OriginalOC/Unity64/media/case/case_top.png

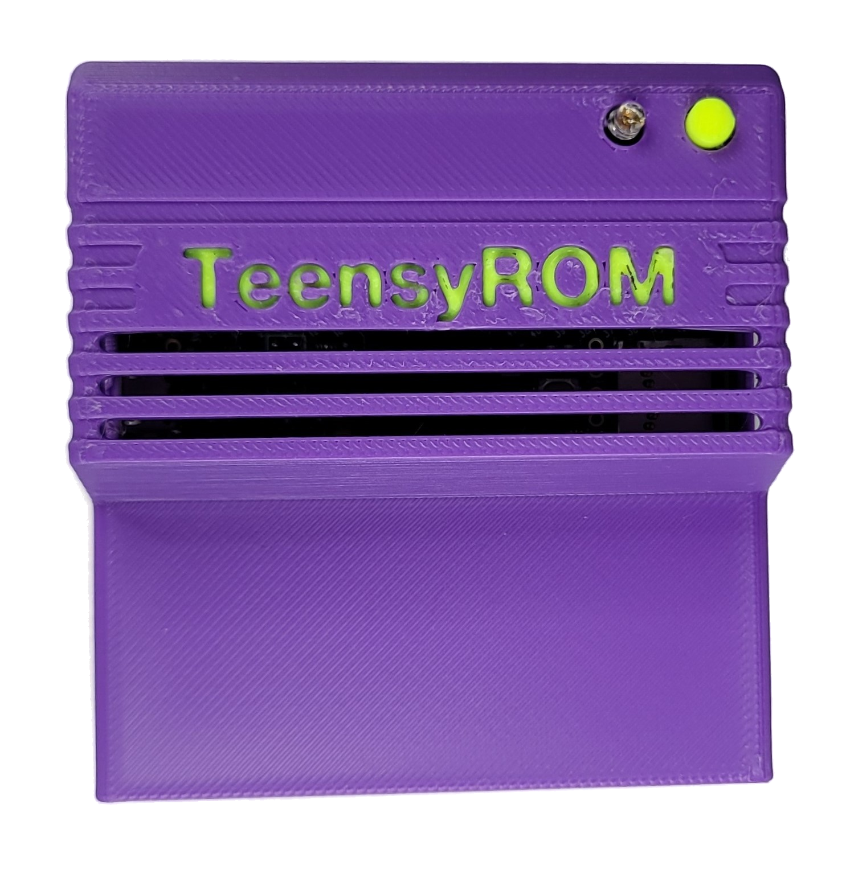
media/case/case_top.png
