OriginalOC/Unity64/media/NFC/Ali_Combo.jpg

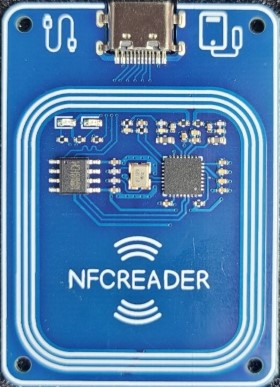
media/NFC/Ali_Combo.jpg
