OriginalOC/Unity64/media/NFC/Discrete_Top_Bot.webp

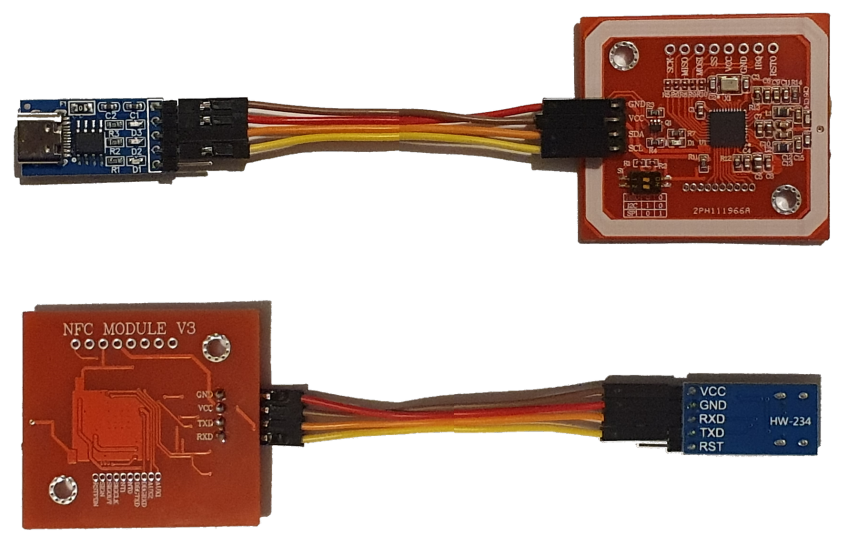
media/NFC/Discrete_Top_Bot.webp
