OriginalOC/Unity64/media/NFC/Elec_Combo.jpg

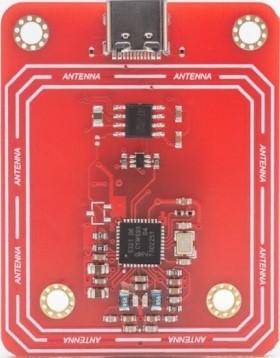
media/NFC/Elec_Combo.jpg
