OriginalOC/Unity64/media/NFC/NFC_1541.jpg

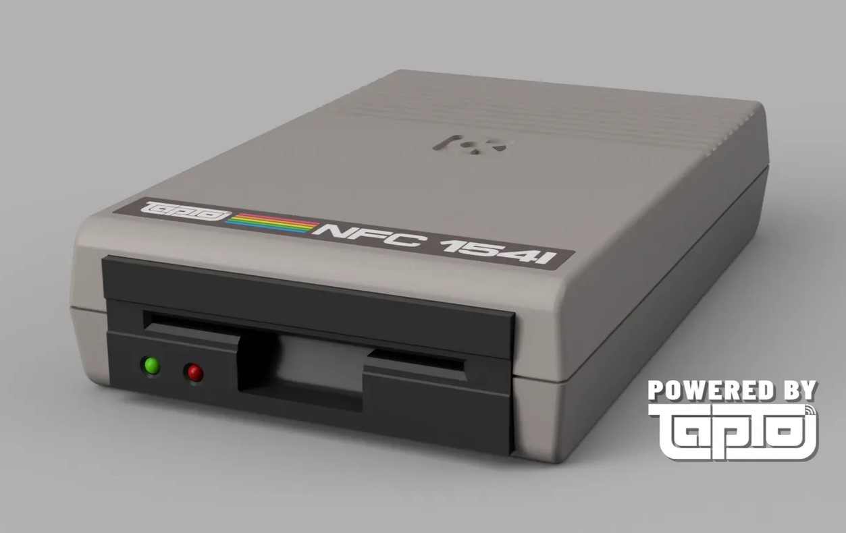
media/NFC/NFC_1541.jpg
