OriginalOC/Unity64/media/NFC/NFC_Engine.jpg

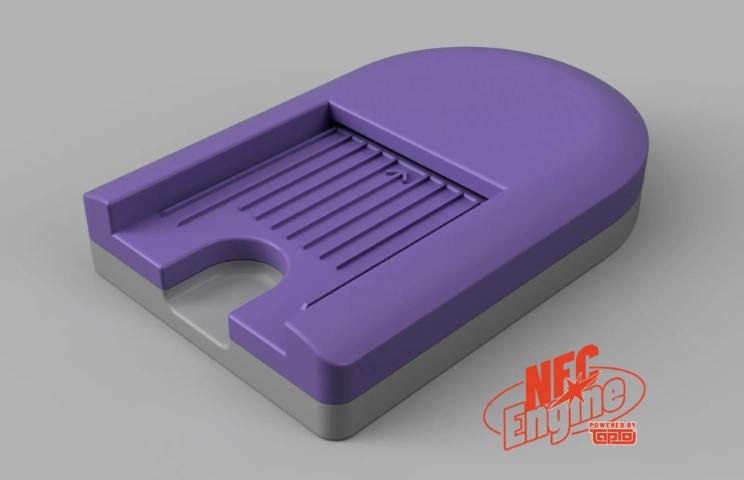
media/NFC/NFC_Engine.jpg
