OriginalOC/Unity64/media/NFC/TapTo_Label_Designer.webp

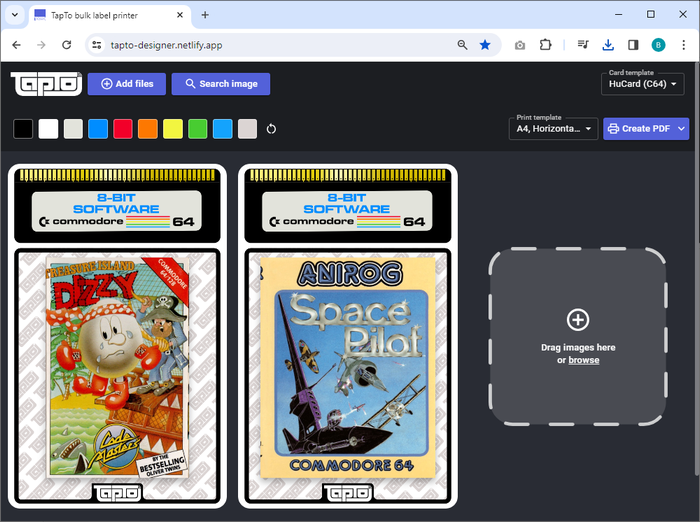
media/NFC/TapTo_Label_Designer.webp
