OriginalOC/Unity64/media/NFC/Write_Tag.jpg

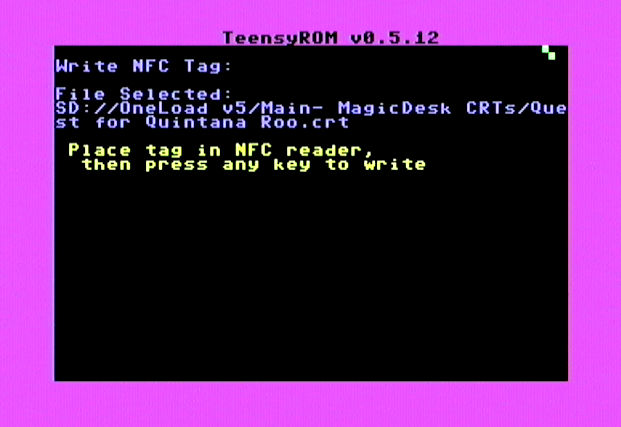
media/NFC/Write_Tag.jpg
