OriginalOC/Unity64/media/Other/tindie-mediums.png

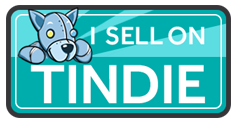
media/Other/tindie-mediums.png
