OriginalOC/Unity64/media/ROMH+VIC timing/TEK0011.JPG

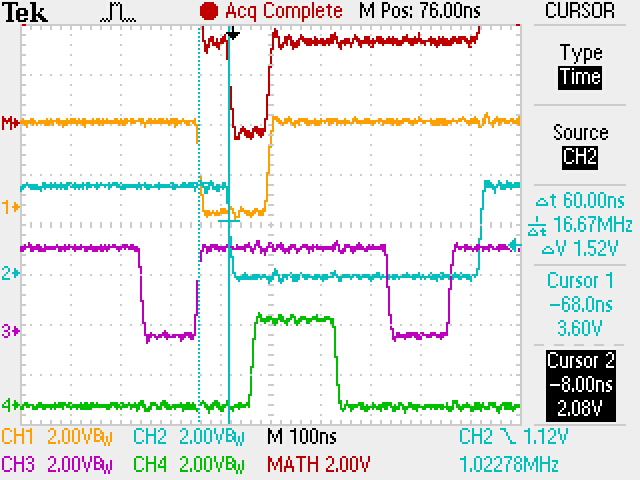
media/ROMH+VIC timing/TEK0011.JPG
