OriginalOC/Unity64/media/ROMH+VIC timing/TEK0014.JPG

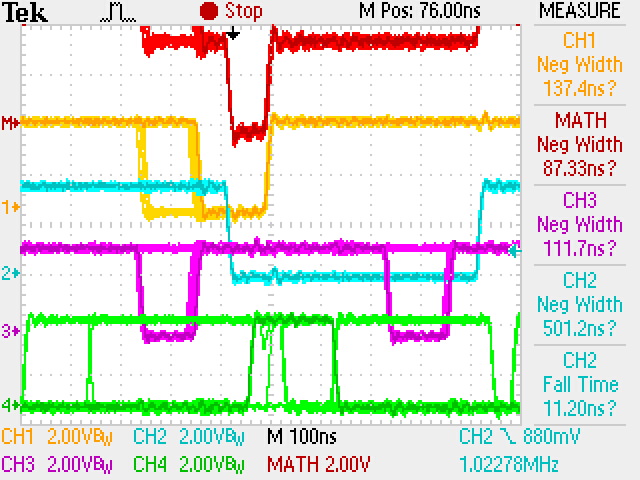
media/ROMH+VIC timing/TEK0014.JPG
