OriginalOC/Unity64/media/Screen captures/ASID Player.png

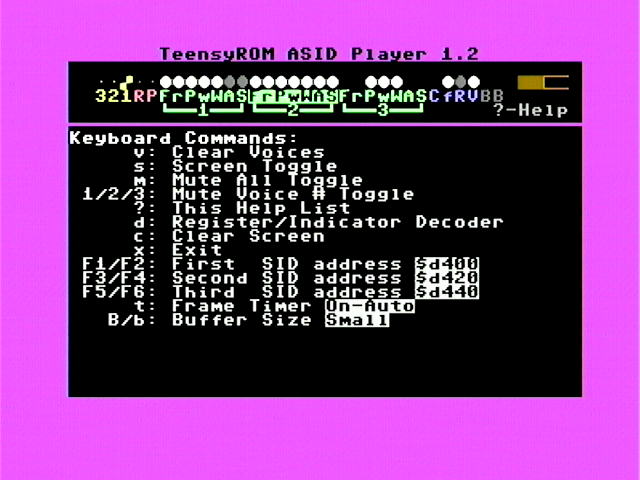
media/Screen captures/ASID Player.png
