OriginalOC/Unity64/media/Screen captures/Color Settings.png

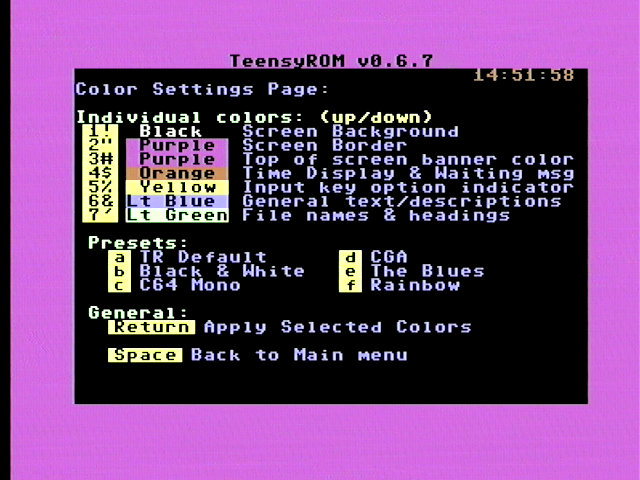
media/Screen captures/Color Settings.png
