OriginalOC/Unity64/media/Screen captures/DMA_Check_Pass.png

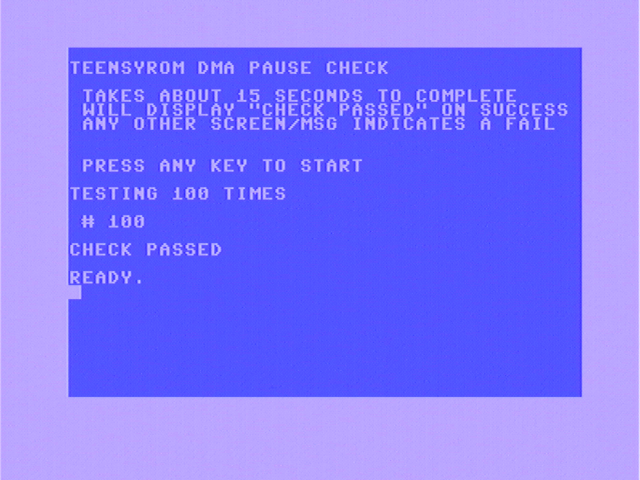
media/Screen captures/DMA_Check_Pass.png
