OriginalOC/Unity64/media/Screen captures/Help Menu.png

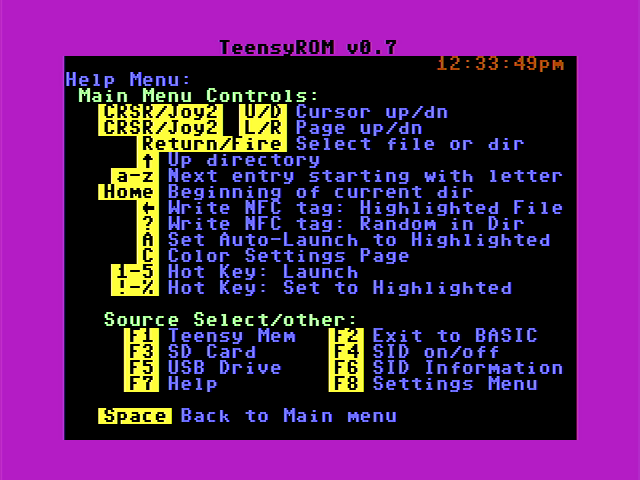
media/Screen captures/Help Menu.png
