OriginalOC/Unity64/media/Screen captures/Main Menu.png

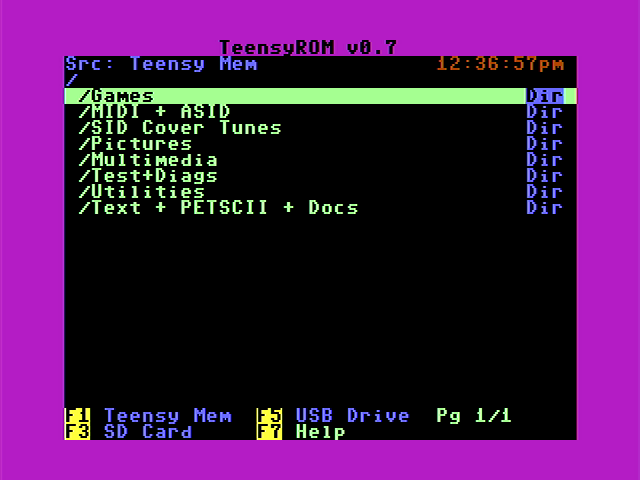
media/Screen captures/Main Menu.png
