OriginalOC/Unity64/media/Screen captures/MIDI to SID.png

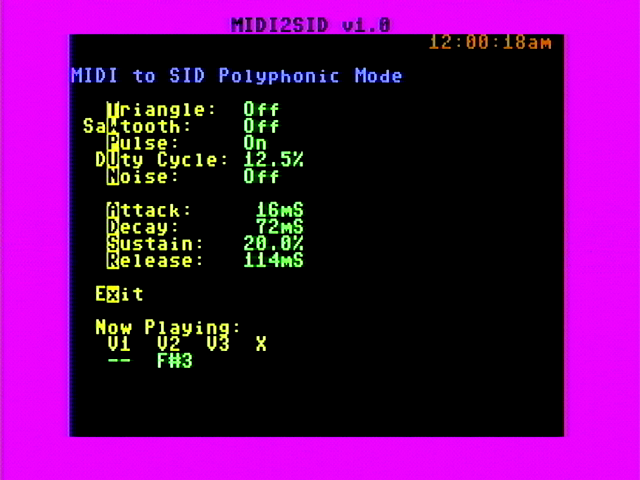
media/Screen captures/MIDI to SID.png
