OriginalOC/Unity64/media/Screen captures/Settings Menu.png

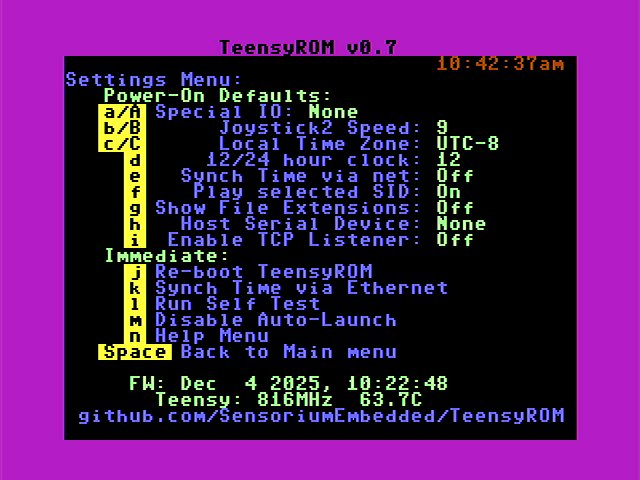
media/Screen captures/Settings Menu.png
