OriginalOC/Unity64/media/Screen captures/SIDInfoPage.png

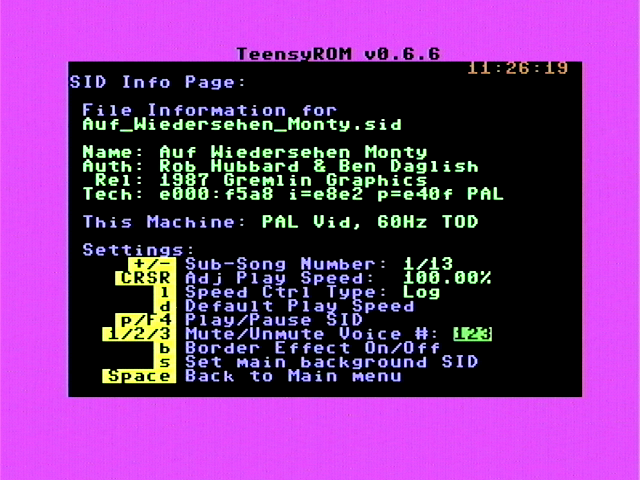
media/Screen captures/SIDInfoPage.png
