OriginalOC/Unity64/media/Screen captures/Text_PETSCII Viewer doc.png

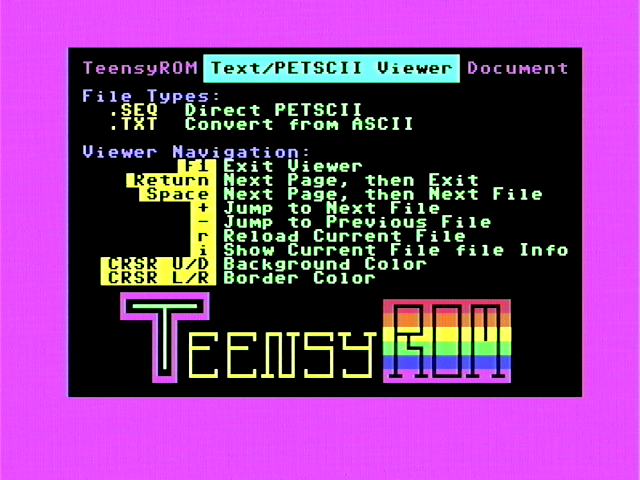
media/Screen captures/Text_PETSCII Viewer doc.png
