OriginalOC/Unity64/media/Screen captures/USB Devices.jpg

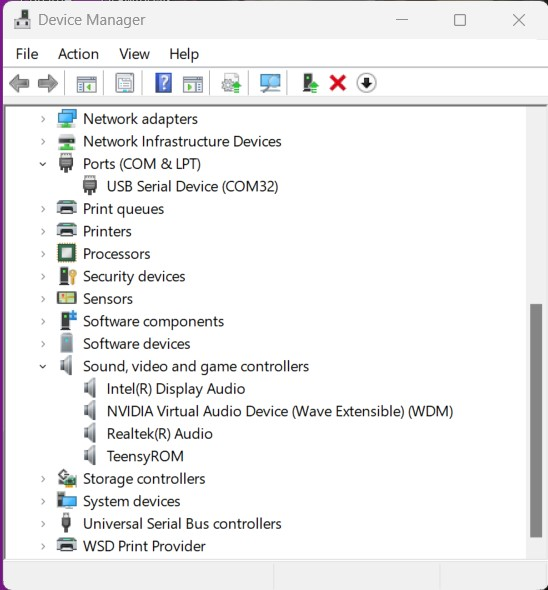
media/Screen captures/USB Devices.jpg
