OriginalOC/Unity64/media/Screen captures/USB Menu.png

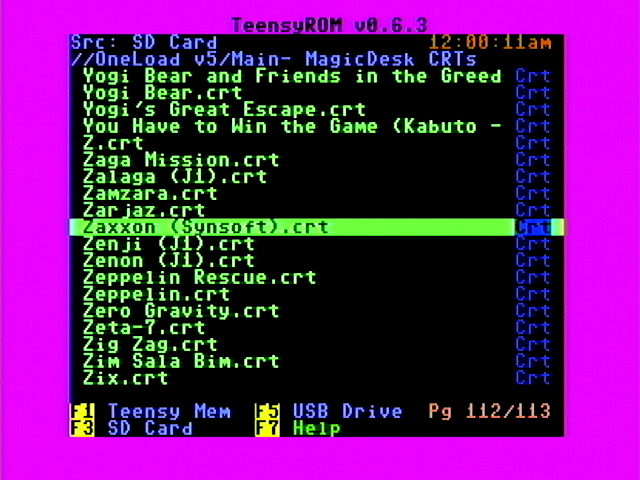
media/Screen captures/USB Menu.png
