OriginalOC/Unity64/media/Screen captures/WinPC x-fer app.png

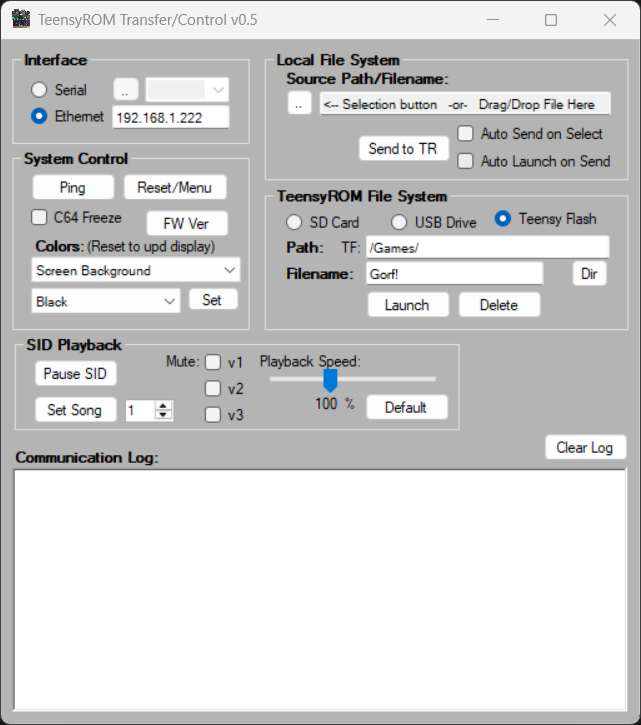
media/Screen captures/WinPC x-fer app.png
