OriginalOC/Unity64/media/Teensy/Teensy Bot Pins.jpg

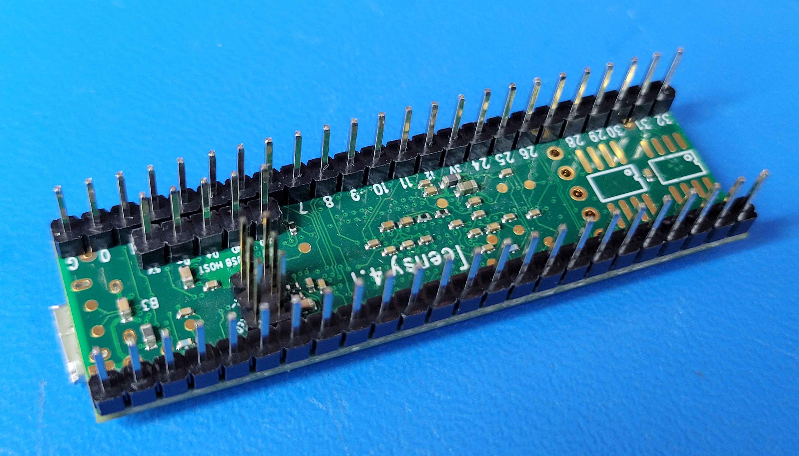
media/Teensy/Teensy Bot Pins.jpg
