OriginalOC/Unity64/media/Teensy/Teensy Power.jpg

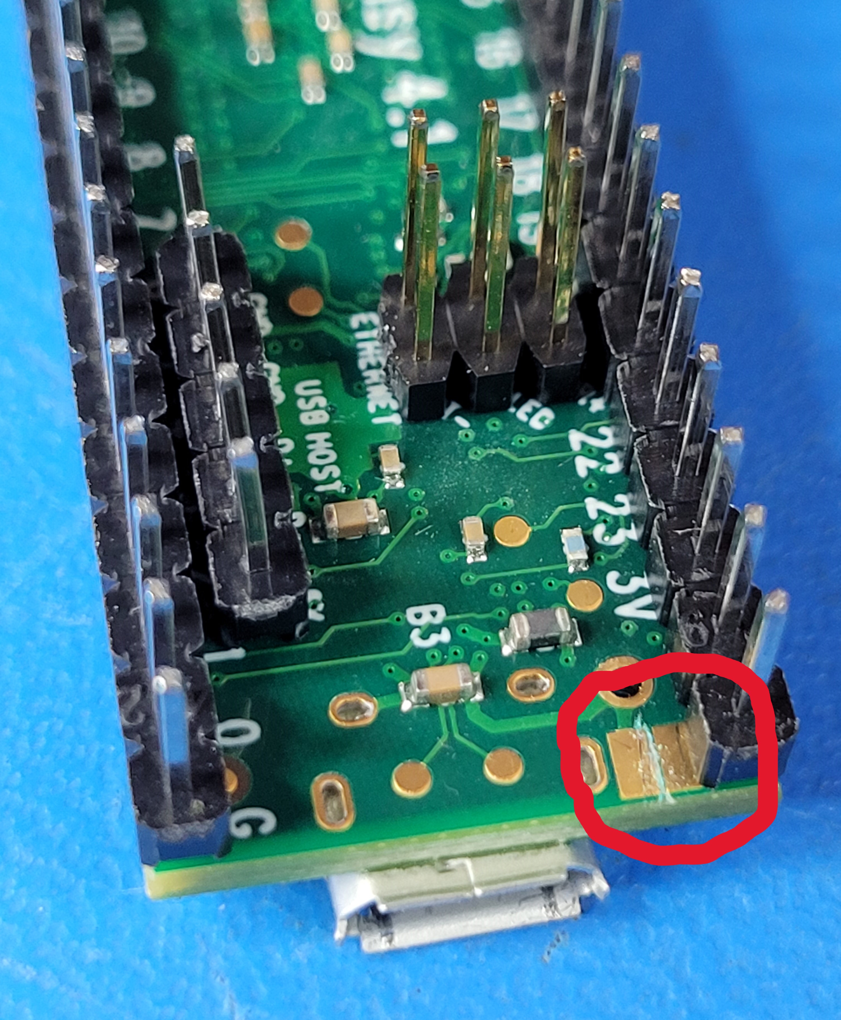
media/Teensy/Teensy Power.jpg
