OriginalOC/Unity64/media/Teensy/Teensy Top Pins.jpg

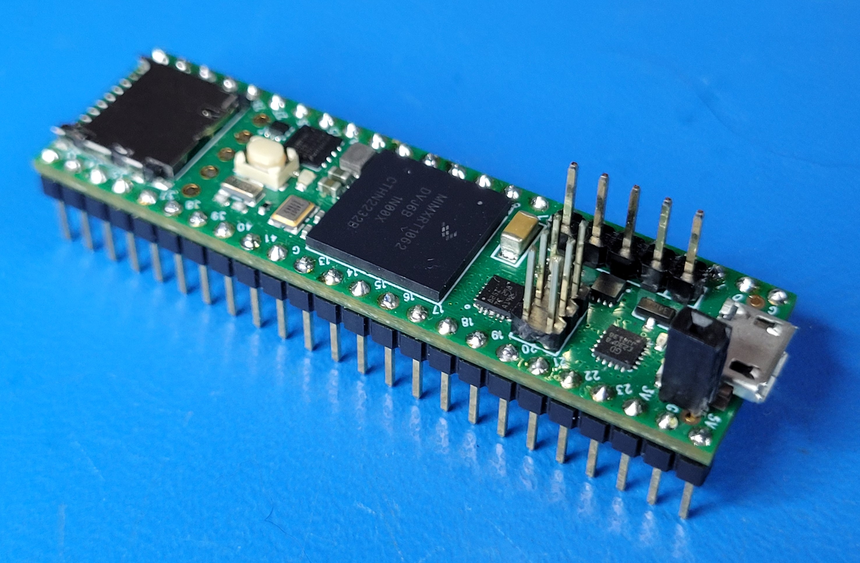
media/Teensy/Teensy Top Pins.jpg
