OriginalOC/Unity64/media/Teensy/USB Power.jpg

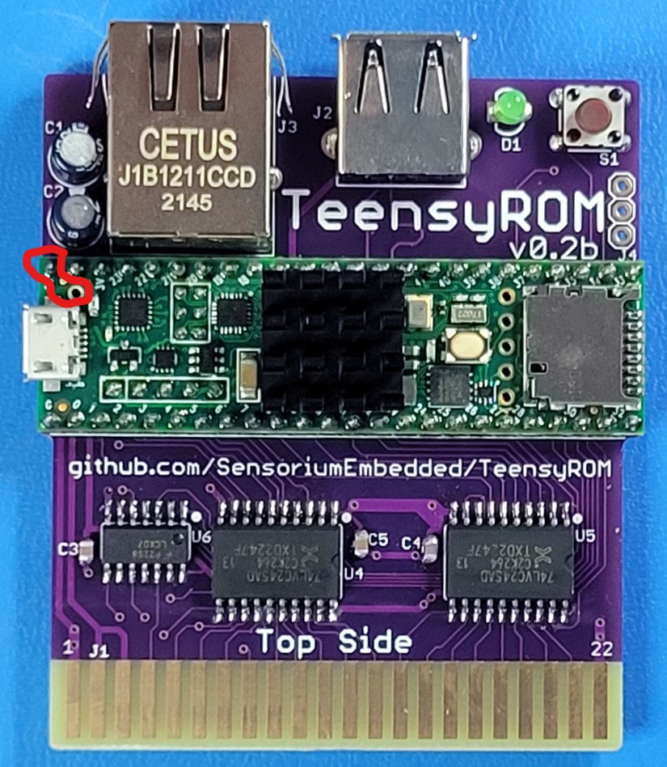
media/Teensy/USB Power.jpg
