OriginalOC/Unity64/media/v0.2b/v0.2b_Bot.jpg

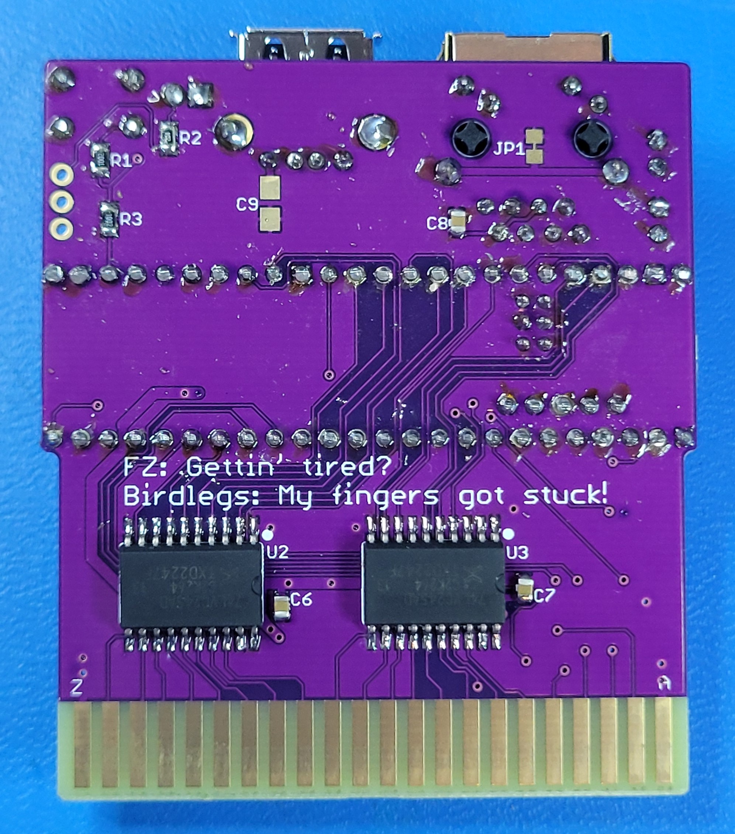
media/v0.2b/v0.2b_Bot.jpg
