OriginalOC/Unity64/media/v0.2b/v0.2b_insitu_USBdrive.jpg

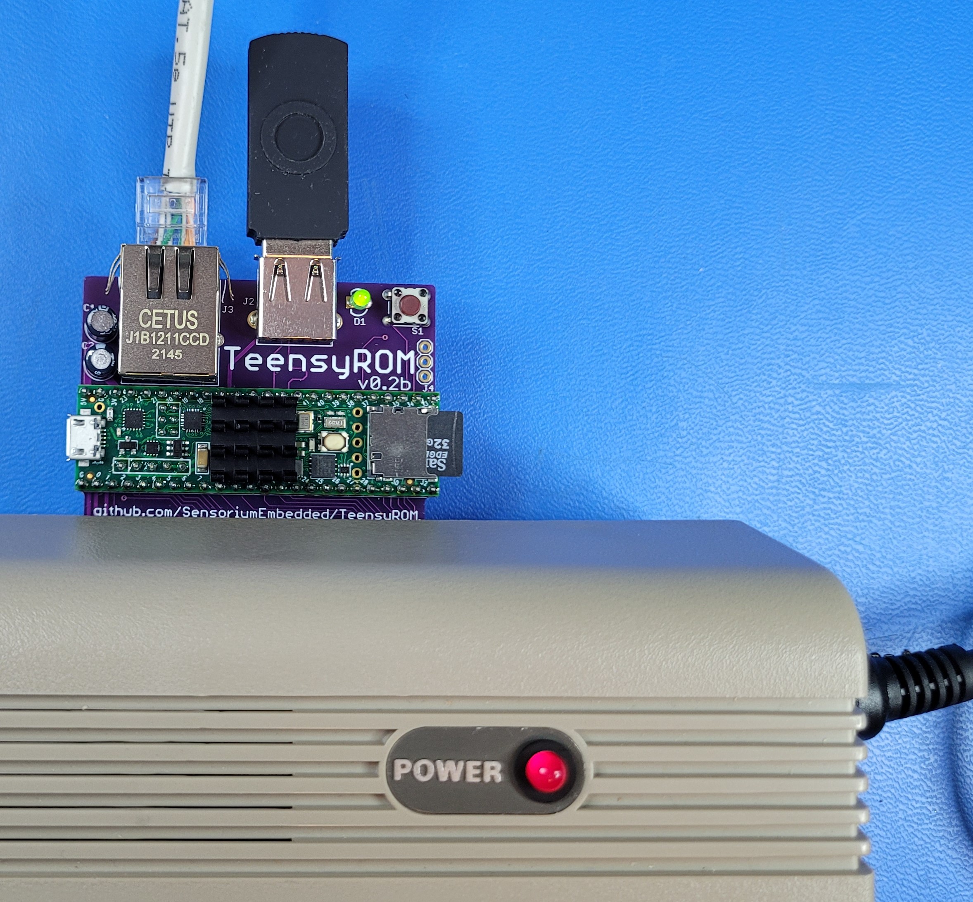
media/v0.2b/v0.2b_insitu_USBdrive.jpg
