OriginalOC/Unity64/media/v0.2c/v0.2c_angle.png

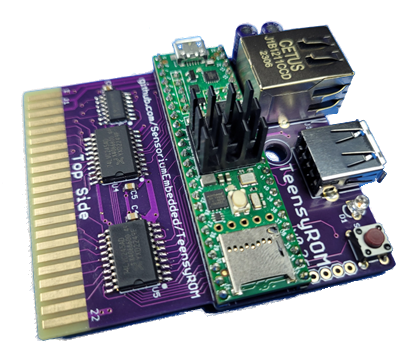
media/v0.2c/v0.2c_angle.png
