OriginalOC/Unity64/PCB/v0.3/TeensyROM v0.3 BOM.xlsx

Sheet: BOM
BOM item # | Qty | Locations/RefDes | Value | Manuf | MPN Highlighted=No Sub | DigiKey PN/link | Cost ea (USD) July 2023 | Extended Cost (USD) | Notes
1 | 1 | PCB | 2 layer 0.063" PCB | OSH Park, JLCPCB, PCBWay | TeensyROM v0.2c | n/a | $10.80 | $10.80 | 2 layer board: 2.40 x 2.70 x 0.063 inches Recommend ENIG finish, 30° chamfered gold fingers, Purple solder mask
2 | 1 | R2 | RES 0805 1K | TE Connectivity | CRG0805F1K0 | A106056CT-ND (https://www.digikey.com/en/products/detail/te-connectivity-passive-product/CRG0805F1K0/2380857) | $0.10 | $0.10
3 | 2 | R1,R3 | RES 0805 10K | TE Connectivity | CRG0805F10K | A106054CT-ND (https://www.digikey.com/en/products/detail/te-connectivity-passive-product/CRG0805F10K/2380831) | $0.10 | $0.20
4 | 6 | C3, C4, C5, C6, C7,C8 | CAP 0805 CER 0.1UF 50V X7R | Samsung | CL21B104KBCNNNC | 1276-1003-1-ND (https://www.digikey.com/en/products/detail/samsung-electro-mechanics/CL21B104KBCNNNC/3886661) | $0.10 | $0.60
5 | 4 | U2, U3, U4, U5 | 74LVC245, SO20W/N | Nexperia Texas Instruments Texas Instruments | 74LVC245AD,118 (Wide) SN74LVC245ADW (Wide) SN74LVC245ANSR (Nar) | 1727-3104-1-ND 296-1232-5-ND 296-13632-1-ND (https://www.digikey.com/en/products/detail/nexperia-usa-inc/74LVC245AD-118/946690) | $0.68 | $2.72 | Octal Bus Transceiver, 3-state Recommend wide package, but any of these 3 will work
6 | 1 | U6 | 74LVC07, SO14 | Texas Instruments OnSemi | SN74LVC07ADR MC74LCX07 | 296-8441-1-ND MC74LCX07DR2GOSCT-ND (https://www.digikey.com/en/products/detail/texas-instruments/SN74LVC07ADR/377390) | $0.50 | $0.50 | Hex BUFFER, open collector HV output Either of these two will work
7 | 1 | U1 | Teensy 4.1 Devel Board w/ Ethernet | PJRC (https://www.pjrc.com/store) | TEENSY41 (https://www.pjrc.com/store/teensy41.html) | 1568-DEV-16771-ND (https://www.digikey.com/en/products/detail/sparkfun-electronics/DEV-16771/12180099) | $33.08 | $33.08 | Be sure to pre-program and then cut the 5v power jumper on the back (see assy instructions)
8 | 2 | U1-Hdr 1/2 | CONN HEADER VERT 1x24 POS 2.54mm (0.1") | Würth | 61302411121 | 732-5331-ND (https://www.digikey.com/en/products/detail/w%C3%BCrth-elektronik/61302411121/4846867) | $1.31 | $2.62 | For Teensy main connections to TeensyROM
9 | 1 | U1-Hdr 3 | CONN HEADER VERT 1x5 POS 2.54mm (0.1") | Würth | 61300511121 | 732-5318-ND (https://www.digikey.com/en/products/detail/w%C3%BCrth-elektronik/61300511121/4846831) | $0.26 | $0.26 | For Teensy USB Host connection to TeensyROM.
10 | 1 | U1-Hdr 4 | CONN HEADER VERT 6POS (2x3) 2MM | METZ CONNECT | PR20C03VBDN | 1849-1000-ND (https://www.digikey.com/en/products/detail/metz-connect-usa-inc/PR20C03VBDN/7794765) | $0.19 | $0.19 | For Teensy Ethernet connection to TeensyROM.
11 | 1 | S1 | SW-MOM-TACTILE | C&K | PTS645SL50-2 LFS | CKN9092-ND (https://www.digikey.com/en/products/detail/c-k/PTS645SL50-2-LFS/1146781) | $0.19 | $0.19
12 | 1 | D1 | LED-3MM-GRN | Lumex Opto | SSL-LX3044GD | 67-1060-ND (https://www.digikey.com/en/products/detail/lumex-opto-components-inc/SSL-LX3044GD/270858) | $0.43 | $0.43 | Polarity: Sq hole = short lead = flat side = '-'(Neg) = Cathode
13 | 2 | C1, C2 | CAP CER 22UF 16V X5R 1210 | Samsung | CL32A226MOJNNNE | 1276-1851-1-ND (https://www.digikey.com/en/products/detail/samsung-electro-mechanics/CL32A226MOJNNNE/3887509) | $0.37 | $0.74
14 | 1 | J3 | RJ-45 w/ Transformer | Cetus/WIZNet | J1B1211CCD | 1278-1052-ND (https://www.digikey.com/en/products/detail/wiznet/J1B1211CCD/7604176) | $3.78 | $3.78 | CONN JACK 1PORT 100 BASE-T PCB
15 | 1 | J2 | USB-A Female | TE/AMP | 292303-1 | A31726-ND (https://www.digikey.com/en/products/detail/te-connectivity-amp-connectors/292303-1/773786) | $1.61 | $1.61 | CONN RCPT USB2.0 TYPEA 4POS R/A
16 | 1 | U1 Heatsink | 12x12mm Aluminum heatsink w/ thermal tape attached Max height to fit in case: ~15mm | Jeteokar | B0B7K2TWZM | https://www.amazon.com/dp/B0B7K2TWZM or https://www.ebay.com/itm/115401351474 | $0.50 | $0.50 | Optional, but recommended Can sub other 12x12mm heatsinks/pads
16a | 1 | U1 Therm Pad | 11x11mm Thermal Conductive Adhesive Tape | Multiple subs, such as these w/ thermal tape attached (https://www.amazon.com/dp/B0B7K2TWZM?th=1) | t-Global TG-T1000-11-11-0.25-5PT | 1168-TG-T1000-11-11-0.25-5PT-ND (https://www.digikey.com/en/products/detail/t-global-technology/TG-T1000-11-11-0-25-5PT/13919490) | $0.20 | $0.20 | If needed (recommended heatsink has thermal pad included)
17 | 1 | C9 | 1210 cap | Do not stuff |  |  |  |  | Not required
18 | 1 | J4 | CONN HEADER VERT 1x4 POS 0.1" | Do not stuff |  |  |  |  | Not required
19 | 1 | J1 | C64-EXPANSION-PORT Gold Fingers | Do not stuff |  |  |  |  | Part of PCB
20 | 2 | U1-Rcpt 1/2 | CONN RCPT VERT 1x24 POS 0.1" |  |  |  |  |  | if socketting Teensy
21 | 1 | U1-Rcpt 3 | CONN RCPT VERT 1x5 POS 0.1" |  |  |  |  |  | if socketting Teensy USB
22 | 1 | U1-Rcpt 4 | CONN RCPT 6POS 0.079 PCB | METZ CONNECT | FR20C03VBDN | 1849-1152-ND |  |  | if socketting Teensy Eth
23 | 1 | U1-EthDongl | Ethernet Kit for Teensy 4.1 | PJRC (https://www.pjrc.com/store) | ETHERNET_KIT |  |  |  | if not using on-board conns
24 | 1 | U1-USBDongl | USB Host Cable For Teensy 4.1 | PJRC (https://www.pjrc.com/store) | CABLE_USB_HOST_T36 |  |  |  | if not using on-board conns
 |  |  |  |  |  |  | Raw Total: | $58.52
 |  |  |  |  |  |  | 10% S&H | $5.85
 |  |  |  |  |  |  | Parts total | $64.37
 |  |  |  |  |  |  | Hand Assy+test | $15.00 | 1 hour labor
 |  |  |  |  |  | Total: Assembled and tested |  | $79.37
 |  |  |  |  |  |  | Plus shipping | tbd

Sheet: 0.2 Export
Qty | Value | Parts | Device | Package | Description | COPYRIGHT | DIGIKEY | MANUF1 | MANUF2 | MANUFACTURER_PART_NUMBER | MFR_NAME | MPN1 | MPN2 | VALUE
2 | 100uF | C1, C2 | CPOL-USE2.5-6 | E2,5-6 | POLARIZED CAPACITOR, American symbol
6 | 0.1 uF | C3, C4, C5, C6, C7, C8 | CAP-0805-0.1UF-50V | 805 | Cap, 0805 |  | 478-10836-2-ND | AVX Corporation | Matsushita |  |  | 08055C104KAT4A | NMC0805X7R104K50TRPF | 0.1 uF
1 | 100uF | C9 | CPOL-EUA/3216-18W | A/3216-18W | POLARIZED CAPACITOR, European symbol
1 | GRN | D1 | LED-3MM-GRN | LED-3MM-PTH | LED 3.1MM PTH |  | 516-1293-ND | Broadcom Limited |  |  |  | HLMP-1503 |  | GRN
1 | C64-EXPANSION-PORT | J1 | C64-EXPANSIONPNARROW | EXPANSIO_SQ
1 |  | J2 | USB-787616 | USB | AMP connector
1 | J1B1211CCD | J3 | J1B1211CCD | CONN12_J1B1211CCD_WIZ |  | Copyright (C) 2023 Ultra Librarian. All rights reserved. |  |  |  | J1B1211CCD | WIZnet
1 | 3 pin Header | J4 | PINHD-1X3 | 1X03 | PIN HEADER
1 | SHORTSMT | JP1 | SHORTSMT | SHORT
2 | 1k | R1, R2 | R-US_R0805 | R0805 | RESISTOR, American symbol
1 | SW-MOM | S1 | SWITCH-MOMENTARY-2PTH | TACTILE-PTH
1 | TEENSY41 | U1 | TEENSY41 | TEENSY41
4 | 74LCV245 | U2, U3, U4, U5 | 74LS245DW | SO20W | Octal BUS TRANSCEIVER, 3-state
1 | 74LVC07 | U6 | 74LS07D | SO14 | Hex BUFFER, open collector high-voltage output
