OriginalOC/Unity64/3D_Print_Case/Archive/v1/TeensyRom-Cart-bottom.stl

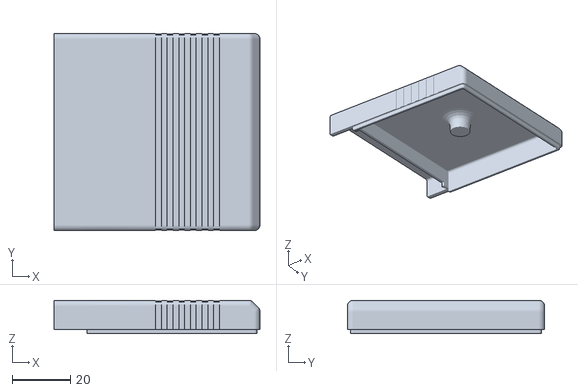
[picture p39: CAD file, 2026-01-08, an earlier design]
3D_Print_Case/Archive/v1/TeensyRom-Cart-bottom.stl
71.0 x 68.0 x 11.5
