OriginalOC/Unity64/3D_Print_Case/Archive/v1/TeensyRom-Cart-top-Vented.stl

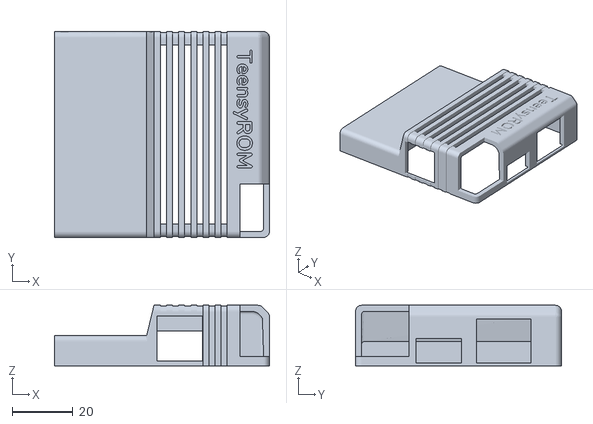
[picture p40: CAD file, 2026-01-08, an earlier design]
3D_Print_Case/Archive/v1/TeensyRom-Cart-top-Vented.stl
71.0 x 68.0 x 20.0
