OriginalOC/Unity64/3D_Print_Case/Archive/v1/TeensyRom-Cart-top-minimal.stl

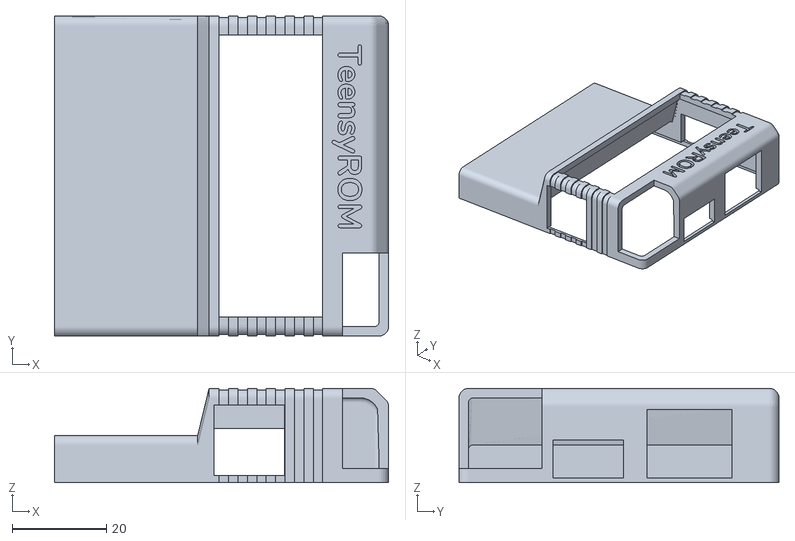
[picture p41: CAD file, 2026-01-08, an earlier design]
3D_Print_Case/Archive/v1/TeensyRom-Cart-top-minimal.stl
71.0 x 68.0 x 20.0
