OriginalOC/Unity64/3D_Print_Case/3D-Printed-Case-ReadMe.md

# Thank you to the TeensyROM community for these case designs!

## "Exposed" Low profile Design by [0ldSkull](https://www.tindie.com/stores/0ldskull/)
  * Models available on [Printables](https://www.printables.com/model/1090478-teensyrom-exposed-case)
  * Complete units available on [0ldSkull's Tindie page](https://www.tindie.com/stores/0ldskull/)

|case back|case rear| 
|:--:|:--:|

## "Classic" Design by [Stefan Wessels](https://github.com/StewBC)
  * V2 (**Latest**)
    * [Models availble here](/3D_Print_Case/TeensyROM-Case-V2-04.zip) See README.txt inside zip file
    * Screw hole accomodation for v0.2c-0.3 PCB
      * Use M2.5x15mm screw [such as this](https://www.amazon.com/dp/B01M0DCMHQ)
    * Version included for v0.2b PCB (No Hole/screw)
  * V1 ([Archived](/3D_Print_Case/Archive/v1/))
    * Vented and minimalist top mods by [MetalHexx](https://github.com/MetalHexx)
  * Based on [C64 Cartridge Case Standard](https://www.thingiverse.com/thing:3932024) by lutzbellmann

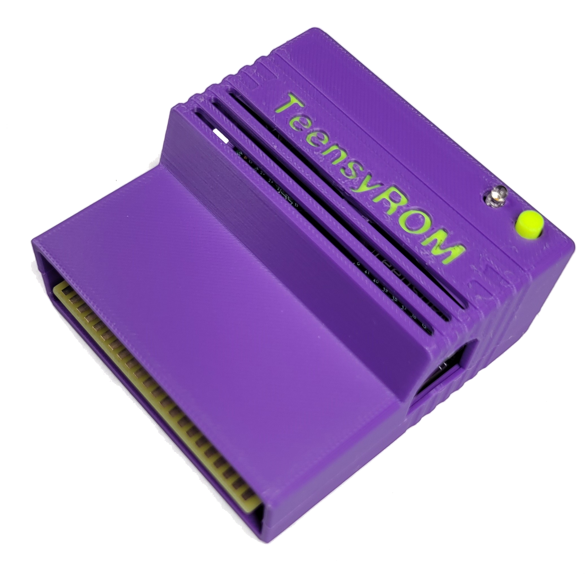
[picture p42: media/case/case-front-corner.png]
case back
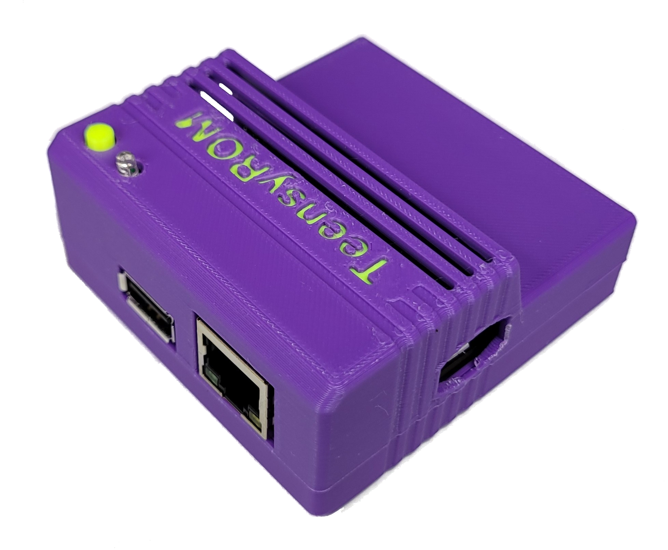
[picture p43: media/case/case-rear-corner.png]
case rear
||| 
|:--:|:--:|
