OriginalOC/Unity64/docs/General_Usage.md

# General TeensyROM usage

## Table of contents
  * [TeensyROM connections and Menu button](#teensyrom-connections-and-menu-button)
  * [Main Menu Options/Navigation](#main-menu-options-navigation)
  * [SD Card (or USB Drive) Setup](#sd-card-or-usb-drive-setup)
  * [Loading files and emulating ROMs](#loading-files-and-emulating-roms)
  * [The Settings Menu](#the-settings-menu)
  * [Selecting and associating Special IO](#selecting-and-associating-special-io)
  * [Firmware updates](#firmware-updates)

## TeensyROM connections and Menu button
  * With the power off, attach the TeensyROM to the Expansion port of your Commodore64 or 128 machine
  * Power on, the TeensyROM main menu should be displayed
  * The Menu button can be pressed at any time to return to the TeensyROM main menu from another program
  * Additional external hardware connection points:
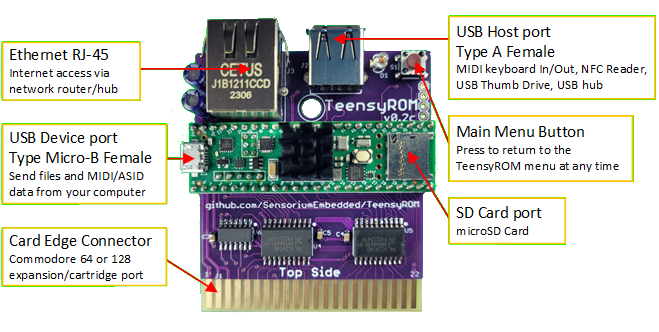
[picture p44: media/TR_Connections.png]
TeensyROM connections
    * 

## Main Menu Options-Navigation
  * (as of FW v0.6.6)
  * Menu navigation: Use the keyboard or a Joystick connected to Control Port 2
    * `CRSR or Joystick Up/Down` Move cursor up/down the list of files on the currently selected source device
    * `CRSR or Joystick Left/Right` Page up/down the list of files
    * `Return or Joystick Fire button` Select/run the highlighted file or enter sub-directory
  * Additional Keyboard commands:
    * `Up Arrow` Up 1 directory level
    * `a-z` (lower case) Search current directory for first item beginning with letter pressed
    * `Home` Move cursor to first item in directory
    * `Left Arrow` Write NFC Tag that will launch currently highlighted file
    * `?` Write NFC Tag that will launch a random file from the currently selected Directory
    * `A` (upper case) Set Auto-Launch to currently highlighted file
    * `C` (upper case) Enter Color Settings Page
    * `1-5` Programmable Hot Keys to immediately launch a specified file
      * Defaults: `1` Cynthcart, `2` Station64, `3` CCGMS, `4` TeensyROM ASID Player, `5` Jupiter Lander CRT
    * `!-%` (Shift `1-5`) Set corresponding Hot Key to currently highlighted file
    * `F1` Display files stored in Teensy Memory via firmware
    * `F3` Display files on an attached SD card
    * `F5` Display files on an attached USB Drive
    * `F7` Show Help Menu
    * `F2` Exit to regular BASIC startup screen, TeensyROM deactivated
      * Re-activate TeensyROM by pressing button
    * `F4` Toggle background SID on/off
    * `F6` Show SID Informartion
    * `F8` Show Settings Menu
  * Screen contents:
    * **File Source and dir path** is shown in the upper left corner
    * **Page number and number of pages** is shown in the lower right corner
    * **Current time** is shown in the upper right (if ethernet connected/synching).  Otherwise the time will start at midnight upon startup.
    * **File type** is to the right of each file/dir displayed. If "Unk" (unknown) then it is not a recognized/supported file type.
      * **'+'** in front of file type means it is pre-associated with Special IO emulation needed for function (MIDI, Swiftlink network) 
    * **Quick Help** is displayed at the bottom of the screen, use F7 for detailed help screen.

## SD Card or USB Drive Setup
  * No TR code is stored on these external drives, so neither are required to start using your TeensyROM and all of its bundled programs.  However, here are some recommendations to extend your enjoyment.
    * SD Cards are somewhat favored over USB drives as they have slightly faster access times.
    * The [OneLoad64 Games Collection (v5)](https://www.youtube.com/watch?v=lz0CJbkplj0) is a great/free source for thousands of CRT files/games in a format (CRT) that's perfect for the TeensyROM
    * The [High Voltage SID Collection](https://hvsc.de/downloads) contains over 50,000 SID files, most of which are directly playable on the TeensyROM.
    * Recommend adding [this autolaunch.txt file](autolaunch.txt) to the root of an SD card in case you want to set up your TeensyROM as an unprompted diagnostics cartridge in the future.
    * 32GB SD cards typically give the fastest directory read times
    * Mac users: Before removing the SD card from your Mac, recommend running the `dot_clean` command on the top-level directory of the volume, e.g. `dot_clean -m /Volumes/TEENSYSD`. This will remove all macOS-specific meta files from the SD card and reduce clutter.
    
## Loading files and emulating ROMs
  * Files can be launched from any of the available sources, including any subdirectory
  * When a file is selected, load/run status is displayed on the screen.  Usually this will flash by too quickly to read, but in the case of an error, it will pause to provide additional information.
  * File types supported:
    * **.PRG and .P00 files:** 
      * Super fast-loads any PRG into C64/128 RAM and executes
        * Same result as LOAD"file",x,1 and RUN (but much faster)
      * Must be single PRG file, not multi-part
    * **.CRT files:**
      * Emulates/supports most popular cartridge types:
        * All 8khi, 8klo, 16k, and C128 "Generic" carts
        * EasyFlash, Magic Desk, Ocean, Dinamic, Zaxxon/Super Zaxxon, GMod2
        * Epyx Fast Load, Game System 3, SuperGames, FunPlay/PowerPlay, Magic Desk 2
        * Ethernet (Swiftlink/Turbo-232), MIDI (Passport, Datel, Sequential, & Namesoft)
      * Additional CRT support info
        * Files larger than 850KB will automatically employ a bank-swap scheme 
          * These files must be run from an SD Card (not USB Stick)
          * Uses "old school" REU type of DMA assertion for fast pausing and no additional CPU execution
            * This method will not work on some systems (Most C128s and a low percentage of NTSC systems)
            * DMA Pause check utility included in Test+Diags dir to test specific system DMA reliability
          * Many large CRT files have been tested with this scheme, all are working smoothly (as long as host C64 passes DMA check)
          * See full CRT implementation details [here](CRT_Implementation.md).
        * On rev 0.2x PCBs, when using the C128 to emulate "Ultimax" carts (Deadtest, Jupiter Lander), some screen artifacts are visible. 
          * This issue only impacts UltiMax CRTs on C128s and is resolved in PCA rev 0.3
        * EasyFlash EAPI not currently supported
    * **.SID files:**
      * Play SID file: ~90% of known SID files are supported
      * Adjusts playback speed based on machine and SID type (NTSC/PAL)
      * SID info screen contains SID header information and playback controls
    * **.KLA/KOA files:**
      * Displays Koala multi-color picture
      * Compatible with output from [Retropixels online](https://www.micheldebree.nl/retropixels/)
    * **.ART/AAS/HPI/OCP/PIC files:**
      * Displays Art Studio Hi-Res picture
    * **.TXT/NFO/MD files:**
      * Displays ASCII text in the TR text viewer
      * See viewer usage/navigation doc via TR on your C64 in the /Text+PETSCII+Docs directory.
    * **.SEQ files:**
      * Displays PETSCII directly in the TR text viewer
      * Compatible with SEQ output from [lvllvl.com](https://lvllvl.com/) and [petscii.krissz.hu](https://petscii.krissz.hu/)
      * See viewer usage/navigation doc via TR on your C64
    * **.D64/.D71/.D81 files:**
      * Single File load/exec only (no multi-file/writebacks)
    * **.HEX files:**
      * Used for TeensyROM firmware updates (see below)

## The Settings Menu 
  * (as of FW v0.7)
  * Keyboard commands available from the Settings Menu:
    * These commands modify settings stored in the Teensy, and are recalled on power-up
      * `a/A` Select Special IO to apply when launching a PRG/CRT (see below)
      * `b/B` Set Port 2 Joystick repeat speed for menu navigation from 0 (very slow) to 15 (super fast) 
      * `c/C` Set local Time Zone for system/screen clock (applied next Ethernet time synch)
      * `d` 12/24 hour clock display
      * `e` Internet Time Synch on power-up
      * `f` Background SID music start on power-up
      * `g` Show file extensions of known file types
      * `h` Select Serial device connected to USB Host Port ([NFC Reader](docs/NFC_Loader.md), [TR Control device](https://github.com/SensoriumEmbedded/TeensyROMControl), or None).
        * Will init identified device on power-up.
      * `i` Ethernet TCP Listenner capability
    * These commands only change settings for this session and execute immediately
      * `j` Reboot TeensyROM to execute updated power-up settings
      * `k` Perform Internet Time Synch now
        * Also displays local IP address
      * `l` Execute Self-Test (takes ~4 seconds)
        * Tests the TeensyROM ability to rapidly read from emulated IO Space
        * Helpful in testing out HW and debug, but should not fail in normal use
        * The is not an exhaustive test, but may be expanded later
      * `m` Disable auto-launch feature.  Re-enable by selecting another program with `Shift-Return` (see above)
      * `n` Display Help menu
      * `Space Bar` Return to Main Menu
      * `Return` Screen refresh.  Handy for updating the temperature reading 
  * Other information on the Settings screen
    * Build Date/Time
      * In addition to the FW version number, the date/time of the build is also logged.
      * This is helpful for tracking custom builds & sub-releases
    * Teensy Frequency and Temperature
      * As mentioned in the main Readme, the Teensy is slightly overclocked to 816MHz in this aplication
      * External cooling is not required for this speed. However, in abundance of caution, a heatsink is specified in the BOM for this project.
      * The max spec is 95C, and there is an automatic shutdown at 90C.
      * Even in extended use, I've never seen the internal temperature exceded 75C.

## Selecting and associating Special IO
  * What is it?
    * "Special IO" in this context means additional HW that is emulated to assist with SW function.
    * This emulation runs at the same time as a selected program/cartridge
    * Examples of these are Swiftlink/Modem, and MIDI interfaces
    * This HW uses the IO1 ($DE00) address space and interrupts to pass information to/from the program running on the C64/128.
  * How is it used/selected?
    * The easy method is to use the software supplied with the TeensyROM with a '+' sign in fron of the type.
      * These will automatically associate the needed IO to emulate Swiftlink Internet or the required MIDI interface.
      * This includes the following, for example:
        * **CCGMS Terminal** Pre-configured and associated with Swiftlink interface to [Ethernet connection](Ethernet_Usage.md)
        * **Cynthcart** Assiciated with the Datel MIDI interface to [USB MIDI Host/Device](MIDI_Usage.md)
        * **Station 64** Assiciated with the Passport MIDI interface [USB MIDI Host/Device](MIDI_Usage.md)
    * Special IO can also be selected in the settings menu
      * This setting will be applied at the time of launching any program or generic cartridge
      * The setting stays in memory and will be re-loaded for any app until changed
      * Recommend disabling NFC if Special IO is selected to avoid interference.
    * If a selected CRT file is associated with different Special IO (ie Epyx, EZFlash etc), that Special IO will be loaded instead

## Resetting EEPROM Contents
  * To set *all* EEPROM values back to default settings:
    * With C64 off, press and hold down menu button on the TeensyROM
    * Power up the C64 (nothing will be displayed)
    * Keep TR menu button pressed for ~10 sec, until the LED starts blinking
    * Release the TR Menu button and wait for the TR menu to be displayed
    * TR EEPROM settings are now reset to default   

## Firmware updates
  There are multiple ways to update the TeensyROM firmware, choose one of the following:

### **From SD Card or USB Thumb Drive**
  * This method is only available in FW v0.4 and higher.
    * Older versions will have to use one of the other methods one time to update
  * Get the .hex file containing the latest major (x.x) or minor(x.x.x) release [from here](/bin/TeensyROM)
  * Copy the file to a USB Thumb drive or SD card
    * This can be done by the traditional method of moving the card to a capable computer
    * Or directly via USB using the **[TeensyROM UI](https://github.com/MetalHexx/TeensyROM-UI)** or Cross-platform **[Command Line Interface](https://github.com/MetalHexx/TeensyROM-CLI)**
  * In the TeensyROM USB or SD Menu, select the Firmware  .hex file
  * A new screen will open and ask you to confirm that you want to update
    * Check that the file name shown is correct
    * 'y' to confirm/continue, 'n' to abort
    * The update process takes about 2 minutes and goes through several stages.
    * ***Important*** You must leave your C64/128 powered up during the update
      * *Interrupting this process could render your TeensyROM unuseable*
    * When the update completes succesfully, your computer will reset and the new version of TeensyROM will be shown
    * If there are any problems, take note of any messages shown before pressing any key to return to the main menu.

### **Directly using TeensyROM via Ethernet connection**
  * Digitalman uses a similar approach in [this video](https://www.youtube.com/watch?v=PGRFLHmw0hY)
  * This method uses features added in FW v0.5.8
    * Older versions will have to use one of the other methods one time to update
  * Connect active Ethernet cable to TeensyROM
    * An inserted SD card (preferred) or USB Thumb drive is also required
  * Open CCGMS from the main menu and type "atbrowse"
  * There are two sites hosting TeensyROM firmware updates, use one of the default bookmarks to enter either of them
    * Bookmark #1 is for the TinyWeb64 site, entering "b1" will take you to sensoriumembedded.com/tinyweb64
    * Bookmark #2 is for Digitalman's site, so "b2" to go to digitalman.azurewebsites.net
    * Alternately the 'U' command will also work: "u sensoriumembedded.com/tinyweb64"
  * From the main menu, link #5 will take you to the Firmware download section on either site
  * Choose the link # for the FW version you want to download/install
    * The FW file will take a minute or two to download, dots shown on screen to indicate progress
  * Use the "d" command to see the local downloaded files directory.
  * Choose the link # of the firmware .hex file downloaded in the previous step to directly launch the update.
    * Check the version and confirm as described in the section above.

### **Using the TeensyLoader application** (requires computer with USB connection)
  * Get the .hex file of the latest released version [from here](/bin/TeensyROM/)
  * Download and install the [Teenyduino/TeensyLoader app](https://www.pjrc.com/teensy/td_download.html)
    * Teensyduino requires arduino to run, which works fine.
    * Alternately, the Teensyloader stand alone file can be downloaded via a link further down the page
  * Launch the Teensyloader/teensyduino app (teensy.exe)
  * Select File, Open HEX File and select the save TeensyROM .hex file
  * Connect the TeensyROM to your computer with a USB A to microB cable.
  * Plug the TeensyROM into your C64/128 and power it up to the main menu
  * Press the white button on the Teensy module itself, as shown in the app
  * The process only takes a few seconds to complete
    * ***Important*** You must leave your C64/128 powered up during the update
  * You should see the app process through erasing and programming before your C64/128 reboots with the new version

### **Using the arduino environment** (for custom builds/code)
  * See the [Software build document](/Source/BuildInfo.md) for details on this process.

<br>

[Back to main ReadMe](/README.md)
