OriginalOC/Unity64/PCB/v0.3/EaglePCB/TeensyROM.brd

## EAGLE design PCB/v0.3/EaglePCB/TeensyROM.brd (2026-01-08)

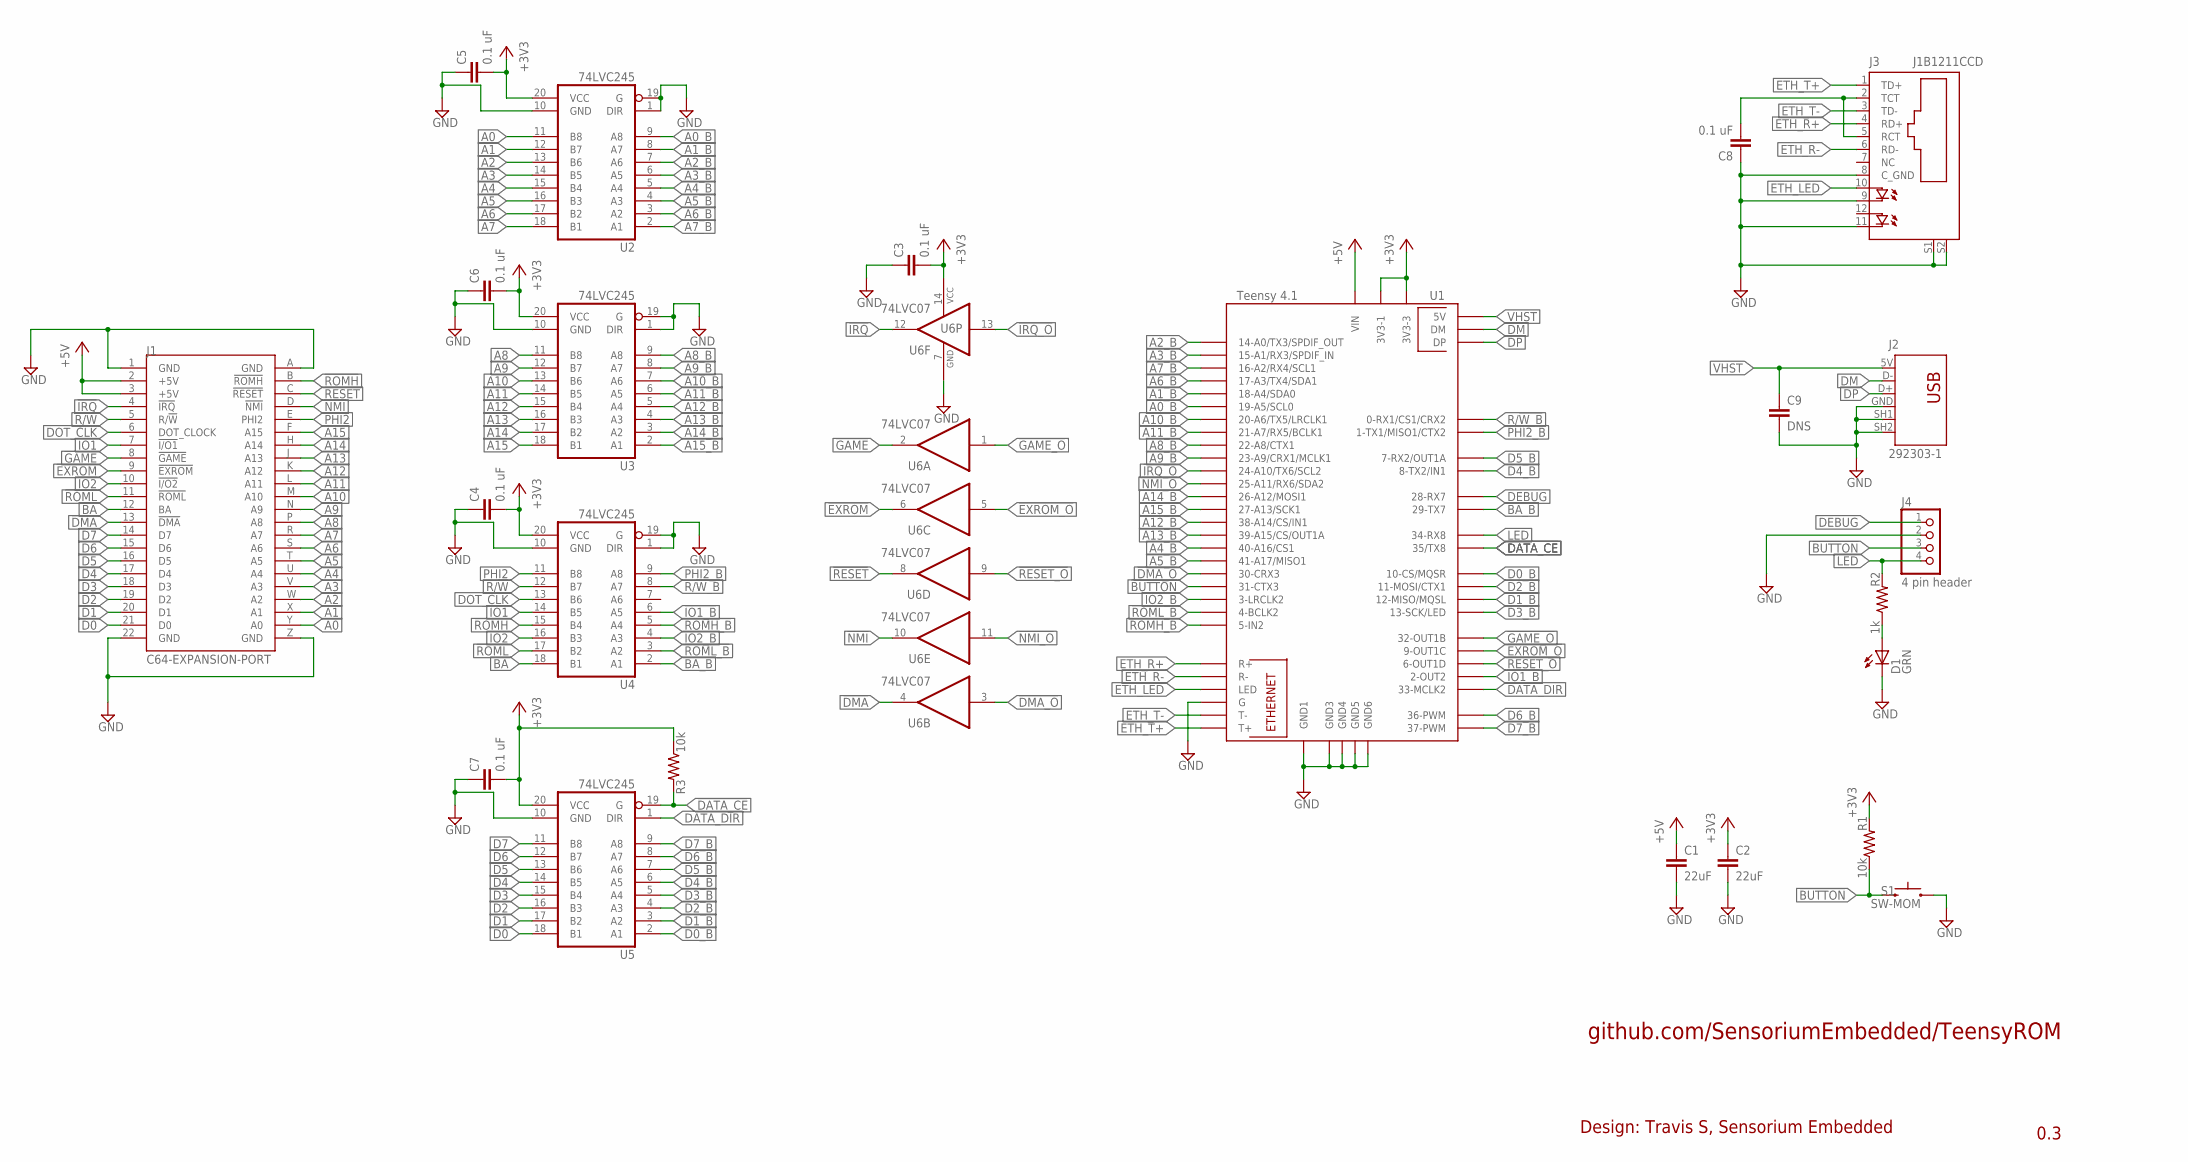
[picture p60: schematic TeensyROM.sch]

Parts:
C1, C2: 22uF; C1210
C3, C4, C5, C6, C7, C8: 0.1 uF; 0805
C9: DNS; C1210
D1: GRN; LED-3MM-PTH
J1: C64-EXPANSION-PORT; EXPANSIO_SQ
J2: 292303-1; USB
J3: J1B1211CCD; CONN12_J1B1211CCD_WIZ
J4: 4 pin header; 1X04
R1, R3: 10k; R0805
R2: 1k; R0805
S1: SW-MOM; TACTILE-PTH
U1: Teensy 4.1; TEENSY41
U2, U3, U4, U5: 74LVC245; SO20W
U6: 74LVC07; SO14

Connections:
!BUTTON: J4.3, R1.1, S1.3 (2), U1.31-CTX3
!DATA_CE: R3.2, U1.35-TX8 (35/TX8), U5.19 (G)
!DMA: J1.13 (!DMA), U6.4 (O)
!DMA_O: U1.30-CRX3, U6.3 (I)
!EXROM: J1.9 (!EXROM), U6.6 (O)
!EXROM_O: U1.9-OUT1C, U6.5 (I)
!GAME: J1.8 (!GAME), U6.2 (O)
!GAME_O: U1.32-OUT1B, U6.1 (I)
!IO1: J1.7 (!I/O1), U4.14 (B5)
!IO1_B: U1.2-OUT2, U4.6 (A5)
!IO2: J1.10 (!I/O2), U4.16 (B3)
!IO2_B: U1.3-LRCLK2, U4.4 (A3)
!IRQ: J1.4 (!IRQ), U6.12 (O)
!IRQ_O: U1.24-A10/TX6/SCL2, U6.13 (I)
!NMI: J1.D (!NMI), U6.10 (O)
!NMI_O: U1.25-A11/RX6/SDA2, U6.11 (I)
!RESET: J1.C (!RESET), U6.8 (O)
!RESET_O: U1.6-OUT1D, U6.9 (I)
!ROMH: J1.B (!ROMH), U4.15 (B4)
!ROMH_B: U1.5-IN2, U4.5 (A4)
!ROML: J1.11 (!ROML), U4.17 (B2)
!ROML_B: U1.4-BCLK2, U4.3 (A2)
+3V3: C2.1, C3.2, C4.2, C5.2, C6.2, C7.2, R1.2, R3.1, U1.3V3-1, U1.3V3-3, U2.20 (VCC), U3.20 (VCC), U4.20 (VCC), U5.20 (VCC), U6.14 (VCC)
+5V: C1.1, J1.2 (+5V), J1.3 (+5V), U1.VIN
A0: J1.Y (A0), U2.11 (B8)
A0_B: U1.19-A5/SCL0, U2.9 (A8)
A1: J1.X (A1), U2.12 (B7)
A1_B: U1.18-A4/SDA0, U2.8 (A7)
A2: J1.W (A2), U2.13 (B6)
A2_B: U1.14-A0/TX3/SPDIF_OUT, U2.7 (A6)
A3: J1.V (A3), U2.14 (B5)
A3_B: U1.15-A1/RX3/SPDIF_IN, U2.6 (A5)
A4: J1.U (A4), U2.15 (B4)
A4_B: U1.40-A16/CS1, U2.5 (A4)
A5: J1.T (A5), U2.16 (B3)
A5_B: U1.41-A17/MISO1, U2.4 (A3)
A6: J1.S (A6), U2.17 (B2)
A6_B: U1.17-A3/TX4/SDA1, U2.3 (A2)
A7: J1.R (A7), U2.18 (B1)
A7_B: U1.16-A2/RX4/SCL1, U2.2 (A1)
A8: J1.P (A8), U3.11 (B8)
A8_B: U1.22-A8/CTX1, U3.9 (A8)
A9: J1.N (A9), U3.12 (B7)
A9_B: U1.23-A9/CRX1/MCLK1, U3.8 (A7)
A10: J1.M (A10), U3.13 (B6)
A10_B: U1.20-A6/TX5/LRCLK1, U3.7 (A6)
A11: J1.L (A11), U3.14 (B5)
A11_B: U1.21-A7/RX5/BCLK1, U3.6 (A5)
A12: J1.K (A12), U3.15 (B4)
A12_B: U1.38-A14/CS/IN1, U3.5 (A4)
A13: J1.J (A13), U3.16 (B3)
A13_B: U1.39-A15/CS/OUT1A, U3.4 (A3)
A14: J1.H (A14), U3.17 (B2)
A14_B: U1.26-A12/MOSI1, U3.3 (A2)
A15: J1.F (A15), U3.18 (B1)
A15_B: U1.27-A13/SCK1, U3.2 (A1)
BA: J1.12 (BA), U4.18 (B1)
BA_B: U1.29-TX7, U4.2 (A1)
D0: J1.21 (D0), U5.18 (B1)
D0_B: U1.10-CS\MQSR (10-CS/MQSR), U5.2 (A1)
D1: J1.20 (D1), U5.17 (B2)
D1_B: U1.12-MISO/MQSL, U5.3 (A2)
D2: J1.19 (D2), U5.16 (B3)
D2_B: U1.11-MOSI/CTX1, U5.4 (A3)
D3: J1.18 (D3), U5.15 (B4)
D3_B: U1.13-SCK/LED, U5.5 (A4)
D4: J1.17 (D4), U5.14 (B5)
D4_B: U1.8-TX2/IN1, U5.6 (A5)
D5: J1.16 (D5), U5.13 (B6)
D5_B: U1.7-RX2/OUT1A, U5.7 (A6)
D6: J1.15 (D6), U5.12 (B7)
D6_B: U1.36-PWM, U5.8 (A7)
D7: J1.14 (D7), U5.11 (B8)
D7_B: U1.37-PWM, U5.9 (A8)
DATA_DIR: U1.33-MCLK2, U5.1 (DIR)
DEBUG: J4.1, U1.28-RX7
DM: J2.D- (2), U1.DM
DOT_CLK: J1.6 (DOT_CLOCK), U4.13 (B6)
DP: J2.D+ (3), U1.DP
ETH_CT: C8.2, J3.2 (TCT), J3.5 (RCT)
ETH_LED: J3.10 (A), U1.LED
ETH_R+: J3.4 (RD+), U1.R+
ETH_R-: J3.6 (RD-), U1.R-
ETH_T+: J3.1 (TD+), U1.T+
ETH_T-: J3.3 (TD-), U1.T-
GND: C1.2, C2.2, C3.1, C4.1, C5.1, C6.1, C7.1, C8.1, C9.2, D1.K (C), J1.1 (GND), J1.22 (GND), J1.A (GND), J1.Z (GND), J2.GND (4), J2.SH1 (5), J2.SH2 (6), J3.8 (C_GND), J3.9 (C), J3.11 (C1), J3.S1, J3.S2, J4.2, S1.1, U1.G, U1.GND1, U1.GND3, U1.GND4, U1.GND5, U1.GND6, U2.1 (DIR), U2.10 (GND), U2.19 (G), U3.1 (DIR), U3.10 (GND), U3.19 (G), U4.1 (DIR), U4.10 (GND), U4.19 (G), U5.10 (GND), U6.7 (GND)
LED: J4.4, R2.2, U1.34-RX8
LED_R: D1.A, R2.1
PHI2: J1.E (PHI2), U4.11 (B8)
PHI2_B: U1.1-TX1/MISO1/CTX2, U4.9 (A8)
R/!W: J1.5 (R/!W), U4.12 (B7)
R/!W_B: U1.0-RX1/CS1/CRX2, U4.8 (A7)
VHST: C9.1, J2.5V (1), U1.+5V (5V)

Notes on the sheet:
0.3
github.com/SensoriumEmbedded/TeensyROM
Design: Travis S, Sensorium Embedded

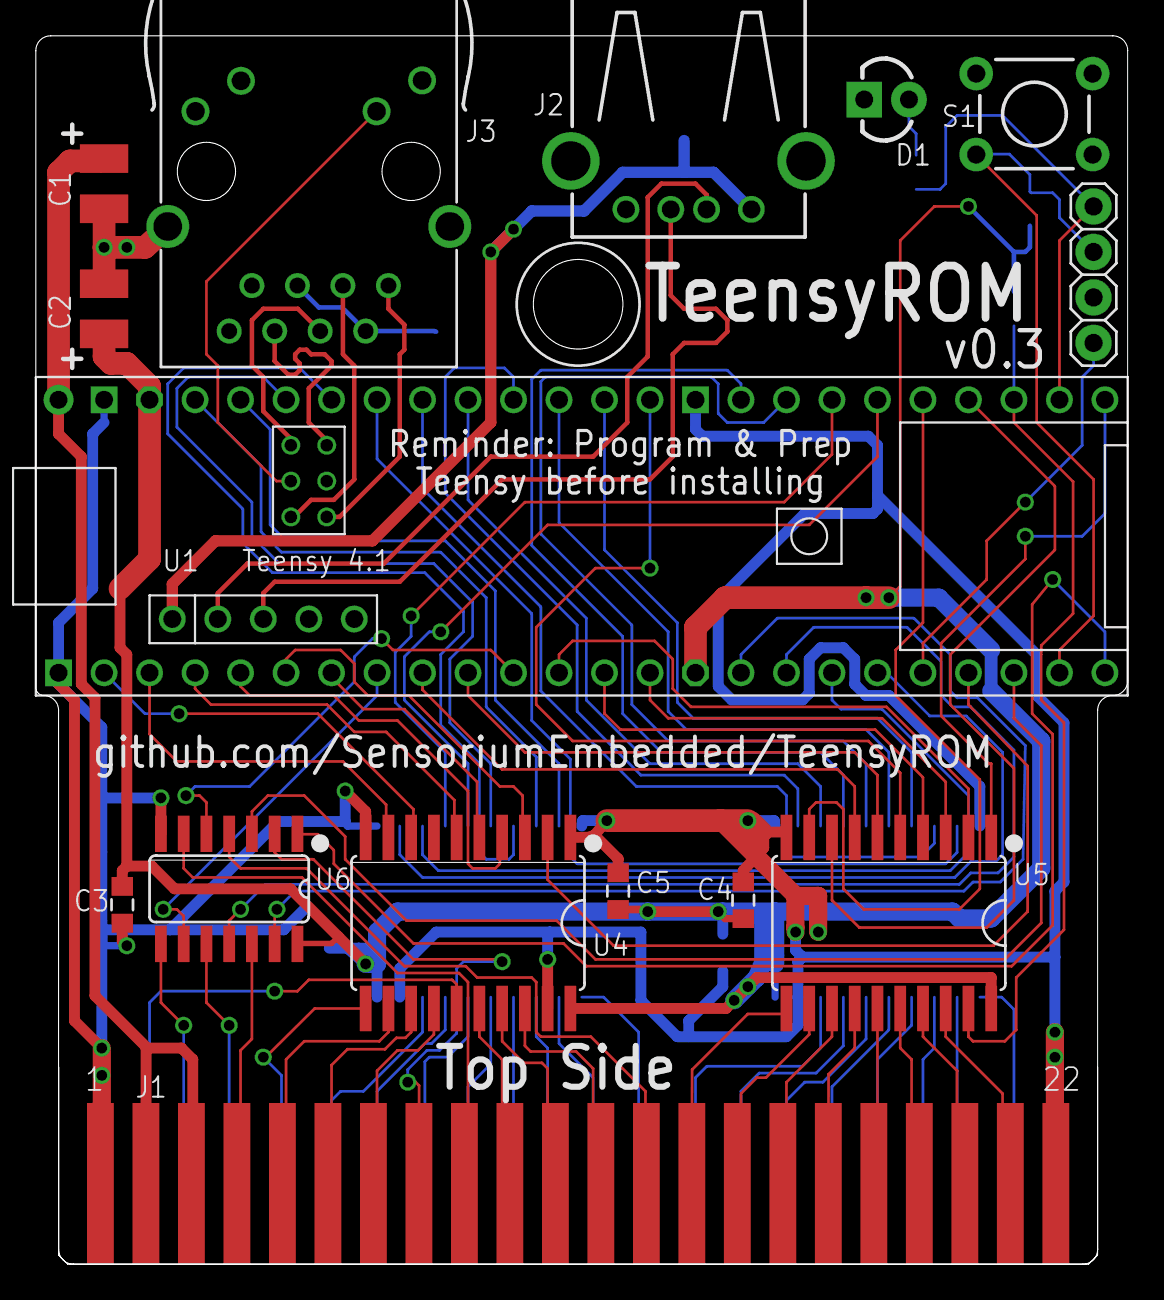
[picture p61: board TeensyROM.brd from above]

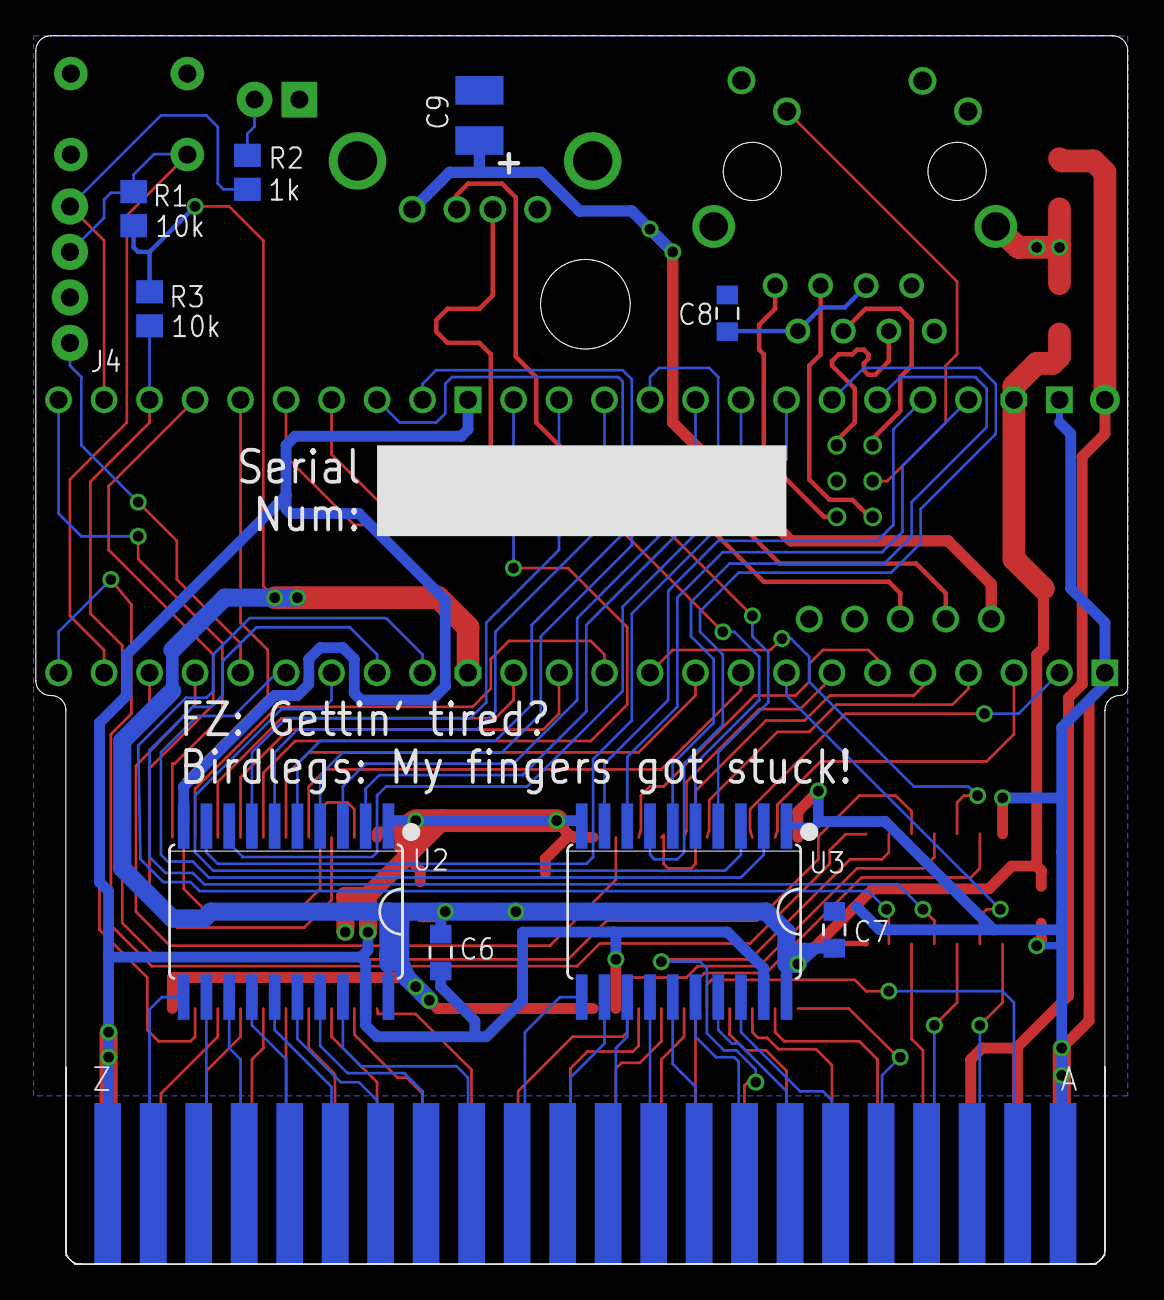
[picture p62: board TeensyROM.brd from below]

Board: 2 copper layers, 61.0 x 68.6 mm, 25 parts (9 on the bottom side), 93 nets.

Other parts of the board:
U$1: 3,0
