OriginalOC/Unity64/(commit log)

2026-01-08 refactor: move Teensy firmware to Source/u64-teensy and introduce autoconf build
2026-01-08 wip: misc workspace changes
    [TeensyROM v0.3 BOM.xlsx, TeensyROM.brd, TeensyROM.sch, TeensyRom-Cart-bottom.stl, TeensyRom-Cart-top-Vented.stl, TeensyRom-Cart-top-minimal.stl]
2026-01-08 wip: u64-teensy autoconf and toolchain work
