OriginalOC/Unity64/(notices)

Notices in the files:
parts and their libraries:
TeensyROM: COPYRIGHT: Copyright (C) 2023 Ultra Librarian. All rights reserved.
